NicoPro03/Car-Guider/README.md

# Car-Guider
Proyect--- Car controller with hands.

---Campusano Nicolas----
---Benitez Gabriel------
---Benitez Bruno--------
