NicoPro03/Car-Guider/car guider/car guider-B_Cu.pdf

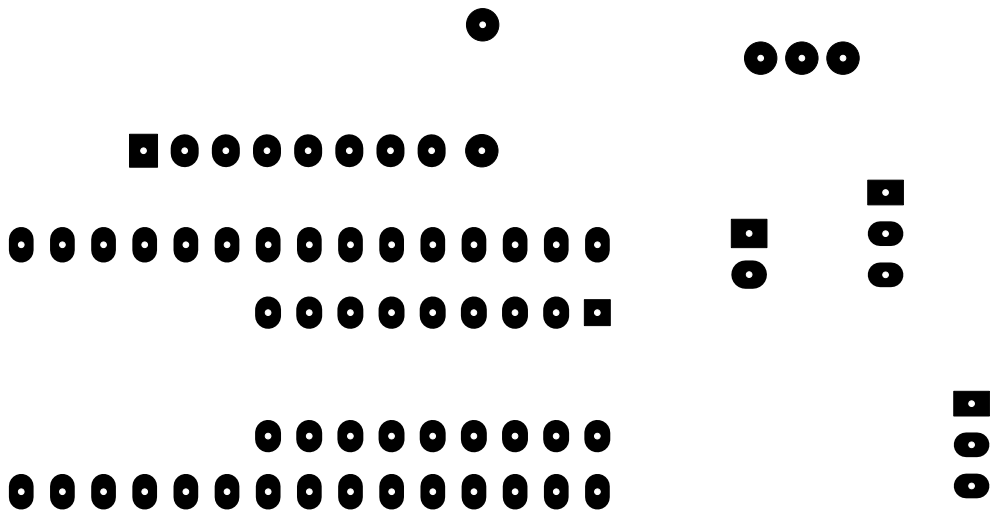
[picture p9: page 1]
