NicoPro03/Car-Guider/car guider/car guider-F_Cu.pdf

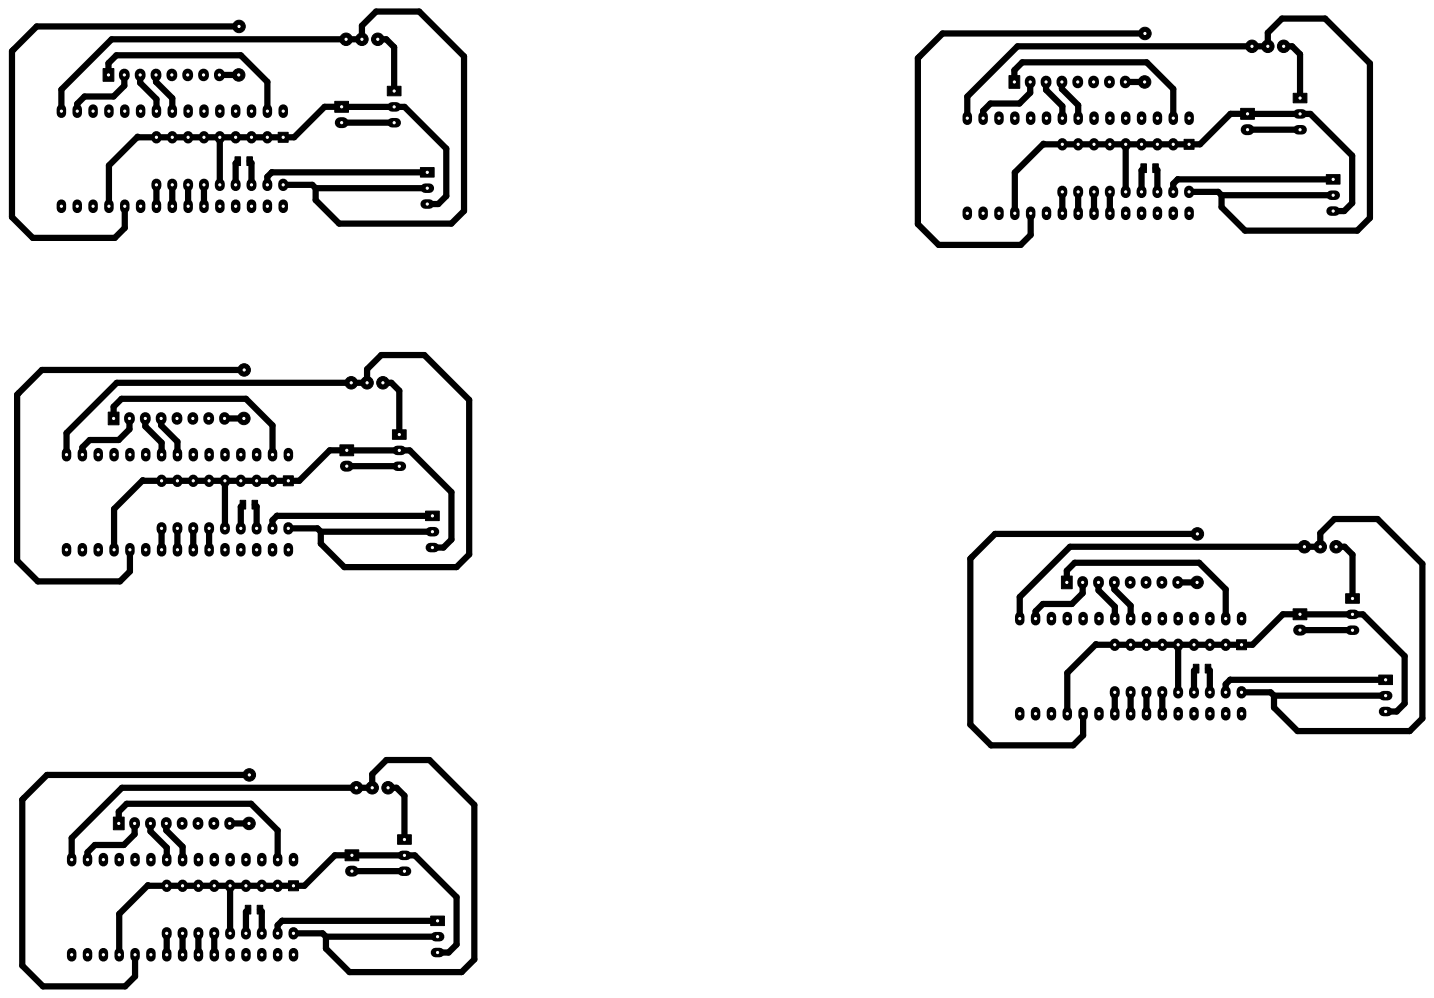
[picture p10: page 1]
