NicoPro03/Car-Guider/Proyecto Acelerometro-Auto/PY-ACE.pdf

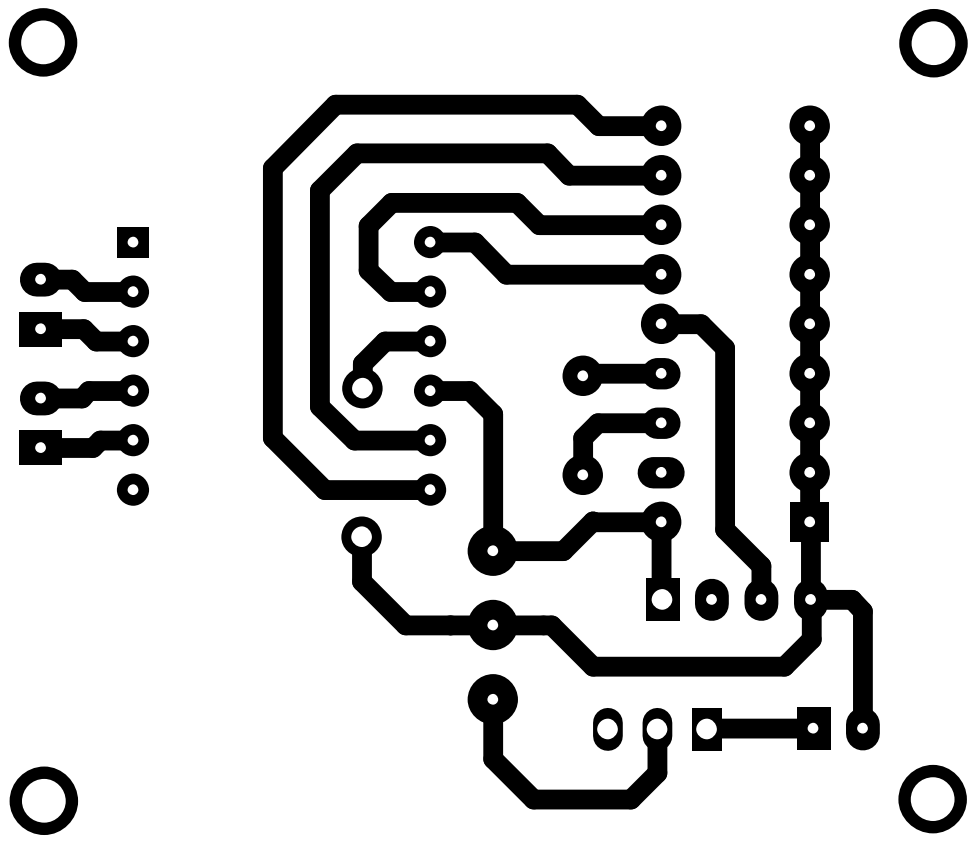
[picture p11: page 1]
