NicoPro03/Car-Guider/Proyecto Acelerometro-Auto/Proyecto Acelerometro.kicad_pcb

## KiCad design Proyecto Acelerometro-Auto/Proyecto Acelerometro.kicad_pcb (2022-11-25)

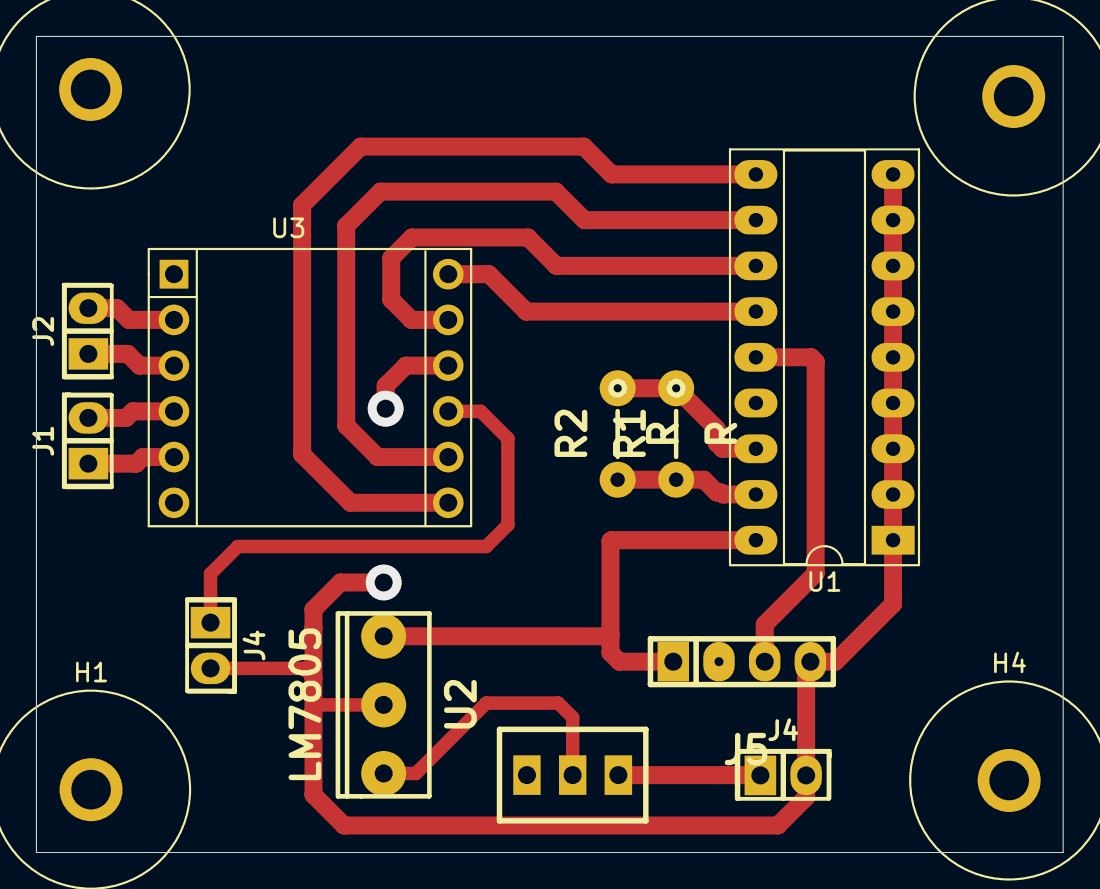
[picture p12: board Proyecto Acelerometro.kicad_pcb from above]

Board: 2 copper layers, 57.0 x 45.3 mm, 15 parts (0 on the bottom side), 15 nets.

Parts:
H1, H2, H3, H4: MountingHole_Pad; Banana_Jack_1Pin
J1, J2: MOTOR; Pin_Header_2
J4, J4#2: BATERIA; Pin_Header_2
J5: RF-5V; pin_strip_4
R1, R2: R; RES0.2
SWITCH1: SW_Push; SW_SPDT_TH_100Mils_VERTICAL
U1: HT12D; DIP-18_300_socket
U2: LM7805; to220
U3: Drv8833; DRV8833

Connections:
/DATA: J5.3, U1.14
/GND: J4.2, J4#2.2, J5.4, U1.1, U1.2, U1.3, U1.4, U1.5, U1.6, U1.7, U1.8, U1.9, U2.2, U3.10 (GND)
/IN1: U1.10, U3.7 (IN1)
/IN2: U1.11, U3.8 (IN2)
/IN3: U1.12, U3.11 (IN3)
/IN4: U1.13, U3.12 (IN4)
/OUT1: J2.2, U3.1 (OUT1)
/OUT2: J2.1, U3.3 (OUT2)
/OUT3: J1.2, U3.4 (OUT3)
/OUT4: J1.1, U3.5 (OUT4)
/SW1: J4#2.1, SWITCH1.1
/SW2: SWITCH1.2, U2.1
/VCC: J4.1, J5.1, U1.18, U2.3, U3.9 (VCC)
unnamed: R1.1, R2.1, U1.16
unnamed: R1.2, R2.2, U1.17
