NicoPro03/Car-Guider/(commit log)

2022-11-25 SCH Y PCB
    Dentro de este archivo también se encuentra la huella del Driver8833
2022-11-25 SCH Y PCB
    archivos Kicad
    [Proyecto Acelerometro.kicad_pcb, Proyecto Acelerometro.kicad_sch, Proyecto Acelerometro.sch]
2022-11-25 SCH Y PCB MANO
    Archivos Kicad Mano
    [car guider.kicad_pcb, car guider.kicad_sch]
